lewis-jeffery/DC-coupled-battery-monitor/CT simulator PCB top.png

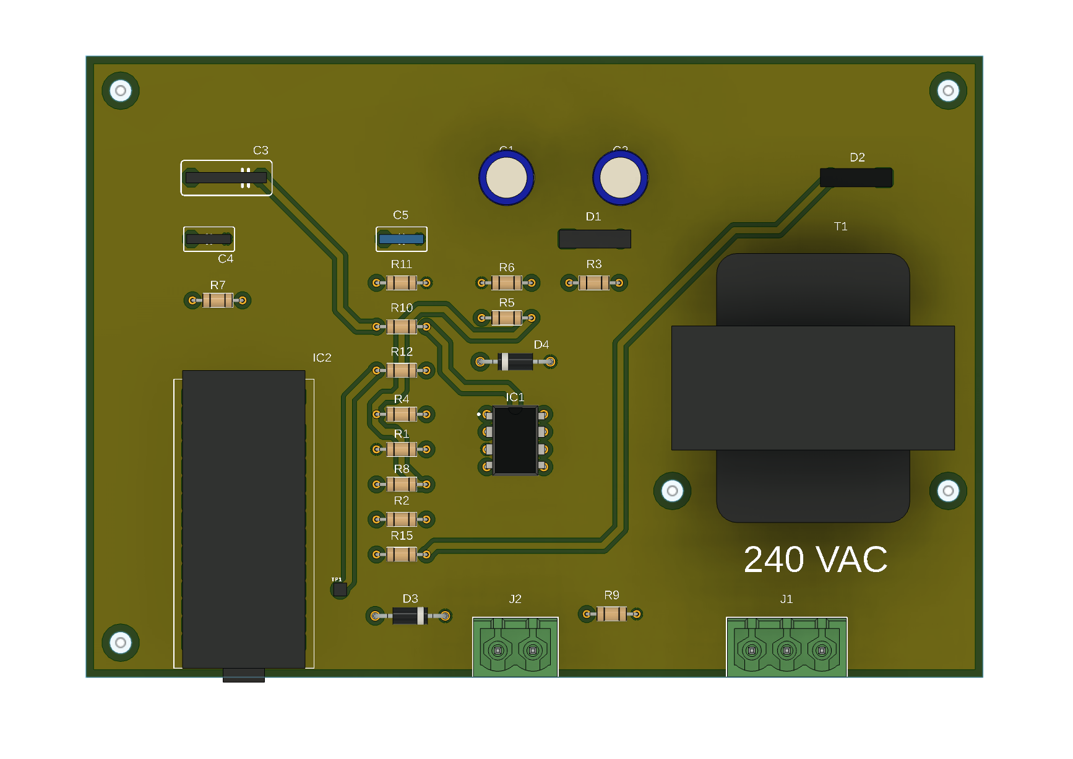
CT simulator PCB top.png
