lewis-jeffery/DC-coupled-battery-monitor/CT_simulator_ schematic.pdf

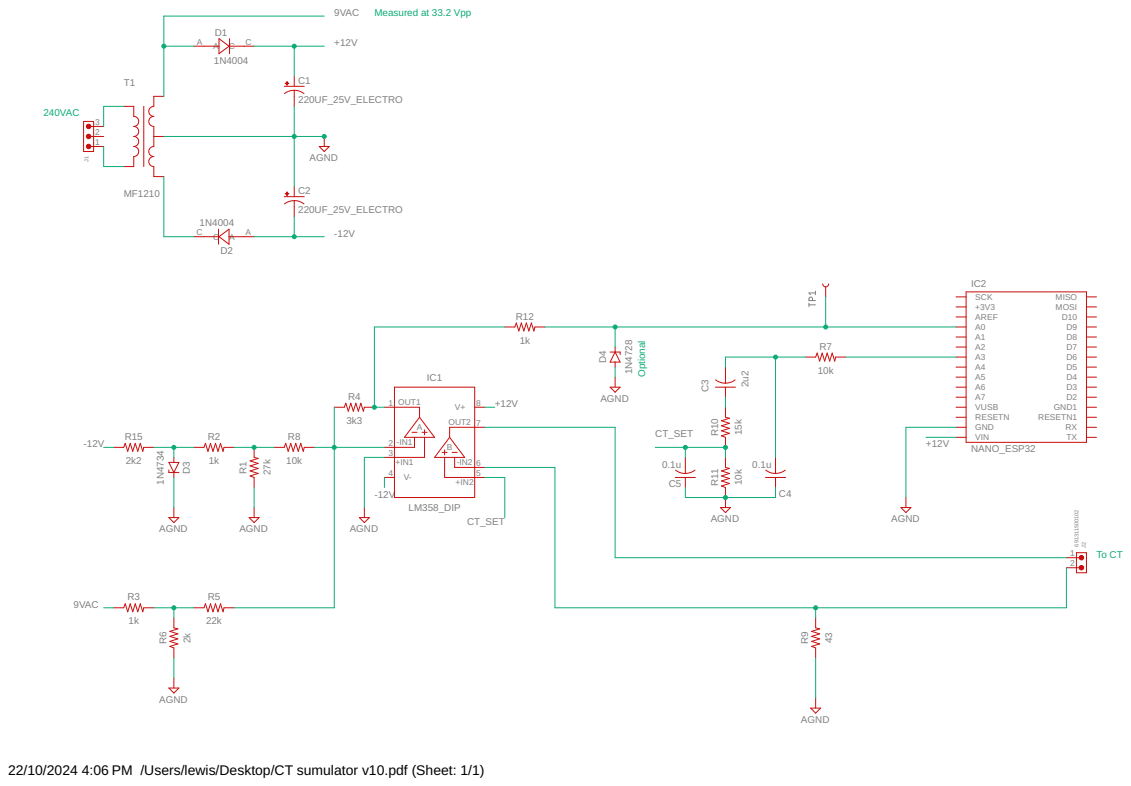
[picture p3: page 1]

22/10/2024 4:06 PM /Users/lewis/Desktop/CT sumulator v10.pdf (Sheet: 1/1)
