lewis-jeffery/DC-coupled-battery-monitor/LTSpice/Simulated CT.asc

C1: cap; 220µ
C2: cap; 220µ
C3: cap; 2.2µ
D1: diode; 1N4004
D2: diode; 1N4004
D3: zener; STZ5_6N
L1: ind2; 100m; Rser=5
L2: ind2; 0.239m
L3: ind2; 0.239m
R1: res; 27k
R2: res; 1k
R3: res; 1k
R4: res; 3k3
R5: res; 22k
R6: res; 2k
R7: res; 43
R8: res; 10k
R9: res; 43
R10: res; 15k
R11: res; 10k
R12: res; 1k
R13: res; 1400
R15: res; 2k2
U1: lm358
U2: lm358
V1: voltage; SINE(0 340 50 0 0 0 100)
Named nets: 0, DC+, DC-, 9VAC, AC_ref
K1 L1 L2 L3 1
.MODEL 1N4004 D  ( IS=76.9p RS=42.0m BV=400 IBV=5.00u
+ CJO=39.8p  M=0.333 N=1.45 TT=4.32u )
.tran 300m
Arduino equivalent load
To ADC of Arduino
From DAC of Arduino
AC mains
